baozhenhao/Balance_Car/docs/前推before.png

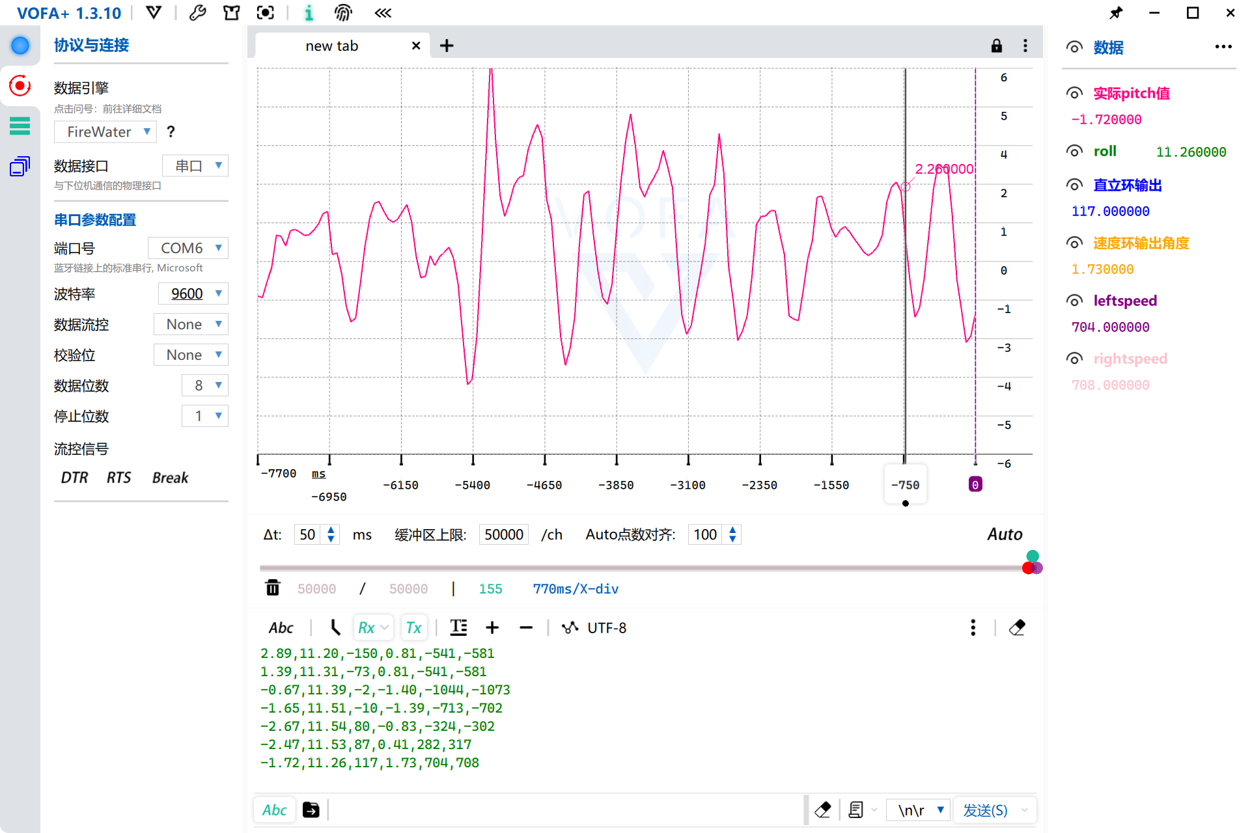
docs/前推before.png
