baozhenhao/Balance_Car/Core/Src/main.c

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
/* Includes ------------------------------------------------------------------*/
#include "main.h"
#include "i2c.h"
#include "tim.h"
#include "usart.h"
#include "gpio.h"

/* USER CODE BEGIN Includes */
#include <stdio.h>
#include "motor.h"
#include "encoder.h"
#include "mpu6050.h"
#include "string.h"
#include "bluetooth.h"
#include "pid.h"
#include "control.h"

/* USER CODE END Includes */


void SystemClock_Config(void);
/* USER CODE BEGIN 0 */

volatile uint8_t ctrl_flag = 0;

/* USER CODE END 0 */

/**
  * @brief  The application entry point.
  * @retval int
  */
int main(void)
{

  /* MCU Configuration--------------------------------------------------------*/

  /* Reset of all peripherals, Initializes the Flash interface and the Systick. */
  HAL_Init();

  /* Configure the system clock */
  SystemClock_Config();

  /* Initialize all configured peripherals */
  MX_GPIO_Init();
  MX_I2C1_Init();
  MX_TIM2_Init();
  MX_TIM3_Init();
  MX_TIM4_Init();
  MX_USART1_UART_Init();
  MX_TIM1_Init();
  /* USER CODE BEGIN 2 */

  // 1. 点亮小蓝板绿色指示灯
   HAL_GPIO_WritePin(GPIOC, GPIO_PIN_13, GPIO_PIN_RESET);

    // 2. 依次唤醒三大器官 (顺序不能乱)
   MPU6050_Init();    // 唤醒小脑
   Encoder_Init();    // 唤醒测速神经
   Motor_Init();
   HAL_TIM_Base_Start_IT(&htim1);
   Control_Init();
   BT_RxStart();
   HAL_Delay(500);                  /* 等传感器上电稳定 */
   MPU6050_CalibrateZero();



  /* USER CODE END 2 */


  /* USER CODE BEGIN WHILE */

   uint32_t last_send   = 0;
   uint32_t last_speed = 0;
   uint32_t last_ctrl_tick = HAL_GetTick();

	    while (1)
   {

	    	/* 5ms：直立环（TIM1 ctrl_flag 触发） */
	    	    if (ctrl_flag)
	    	    {
	    	        ctrl_flag = 0;
	    	        uint32_t now = HAL_GetTick();
	    	        float dt = (now - last_ctrl_tick) * 0.001f;
	    	        last_ctrl_tick = now;

	    	        if (dt < 0.001f) dt = 0.001f;   /* 限幅 */
	    	        if (dt > 0.020f) dt = 0.020f;

	    	        Control_BalanceLoop(dt);
	    	    }
	    	    /* 50ms：速度环 */
	    	    if (HAL_GetTick() - last_speed >= 50)
	    	    {
	    	        last_speed = HAL_GetTick();
	    	        Control_SpeedLoop(0.05f);
	    	    }
	    	    /* 50ms：蓝牙发送 */
	    	    if (HAL_GetTick() - last_send >= 50)
	    	    {
	    	        last_send = HAL_GetTick();
	    	        printf("%.2f,%.2f,%.0f,%.2f,%d,%d\r\n",
	    	               MPU_Pitch, MPU_Roll,
	    	               (double)Control_GetBalanceOut(), (double)Control_GetAngleCmd(),
	    	               (int)enc_left_speed, (int)enc_right_speed);
	    	    }



    /* USER CODE END WHILE */

    /* USER CODE BEGIN 3 */

  }
  /* USER CODE END 3 */
}

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
/* USER CODE BEGIN 4 */
void HAL_TIM_PeriodElapsedCallback(TIM_HandleTypeDef *htim)
{
    if (htim->Instance == TIM1) {


    	ctrl_flag = 1;

    }
}
/* USER CODE END 4 */
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
