baozhenhao/Balance_Car/Core/Inc/mpu6050.h

#ifndef __MPU6050_H
#define __MPU6050_H

#include "main.h"
#include "i2c.h"
#include <math.h>

#define MPU6050_ADDR            0x68 << 1

#define MPU6050_REG_WHO_AM_I    0x75
#define MPU6050_REG_PWR_MGMT1   0x6B
#define MPU6050_REG_ACCEL_XOUT_H 0x3B
#define MPU6050_REG_GYRO_XOUT_H  0x43

typedef struct {
    int16_t ax;
    int16_t ay;
    int16_t az;
} MPU6050_Accel_t;

typedef struct {
    int16_t gx;
    int16_t gy;
    int16_t gz;
} MPU6050_Gyro_t;

extern volatile float MPU_Pitch;
extern volatile float MPU_Roll;
extern volatile float Accel_Pitch;   // 新增：加速度计直接算出的 Pitch
extern volatile float Accel_Roll;
extern volatile float Angle_Zero_Pitch;
//extern float Gyro_Integrated_Pitch; // 新增：陀螺仪积分角度
//extern float Gyro_Integrated_Roll;

uint8_t MPU6050_Init(void);
uint8_t MPU6050_ReadAccel(MPU6050_Accel_t *accel);
uint8_t MPU6050_ReadGyro(MPU6050_Gyro_t *gyro);
void MPU6050_CalibrateZero(void);
//void MPU6050_ReadAll(MPU6050_Accel_t *accel, MPU6050_Gyro_t *gyro);

void MPU6050_GetAngle(float dt);

#endif /* INC_MPU6050_H_ */
