baozhenhao/Balance_Car/(commit log)

2026-04-20 chore：添加.gitignore并移除Debug文件
2026-04-20 chore：从git仓库中移除Debug文件夹
2026-04-20 2026-04-20 点亮小灯，板子基础功能验证通过
2026-04-22 配置电机pwm和编码器引脚
2026-04-23 配置pwm内部时钟，打开I2C服务于MPU6050
2026-04-25 改成4路pwm通道给电机，并为每个外设单独生成.c.h文件
2026-04-25 2026-4-25 添加电机PWM互补驱动函数
2026-04-25 补充：.c的提交
2026-04-27 添加编码器读取和速度计算函数
2026-04-27 test：电机PWM与编码器基础功能验证
2026-04-28 MPU6050驱动代码
2026-05-19 每5ms得到一次电机速度
2026-06-08 买了新打tb6612，改成一个pwm通道两个gpio的配置并更改相应代码
2026-07-19 feat:合并真正可运行的最终版PID控制代码并清理冗余
    1. 全量迁移并合入了 Balance_car3 文件夹中完全调通的自平衡直立与速度闭环核心源码；
    2. 彻底移除了老旧且废弃的 OLED 驱动冗余代码与头文件引用，优化了工程结构；
    3. 验证了软件模拟 I2C 驱动与 MPU6050 姿态传感器数据的稳定性；
    4. 经本地 STM32CubeIDE 重新 Clean 并编译，0 Error，硬件联调测试车体动作正常。
    [Balance_car3.ioc, control.c, control.h, encoder.c, main.c, motor.c, mpu6050.c, mpu6050.h]
2026-08-02 重新设计更完美pid
    新的stm32不用软件模拟i2c了，cpu更快了
2026-08-04 互补滤波波形测试+mpu6050矫正
    mpu6050的z轴和x轴反了
2026-08-09 速度环调成
    基本直立，视频在B站
2026-08-13 readme初版
2026-08-17 chore: 清理 IDE 工作区文件并完善仓库（gitignore/License/README 修正）
2026-08-17 docs: README 补充 B站 演示视频链接
2026-10-29 fix(control): use measured control period as dt
    突然发现直立环10ms进入一次，但是pid和mpu6050都是以5ms来计算，通过计算将对应dt和kp更改让小车回归正轨
2026-10-29 tune(control): Kd=1.0 (10ms dt), speed Kp=0.005 (fix hunting)
    kp的修改，以及后续观察发现速度环力度不够进行skp加强
2026-11-09 docs: 更新 README（控制时序修复记录、before/after 波形、调参说明）
